es-ude/eeg-hardware/0_hardware/EEG.kicad_sch

## KiCad design 0_hardware/EEG.kicad_sch (2026-02-24)

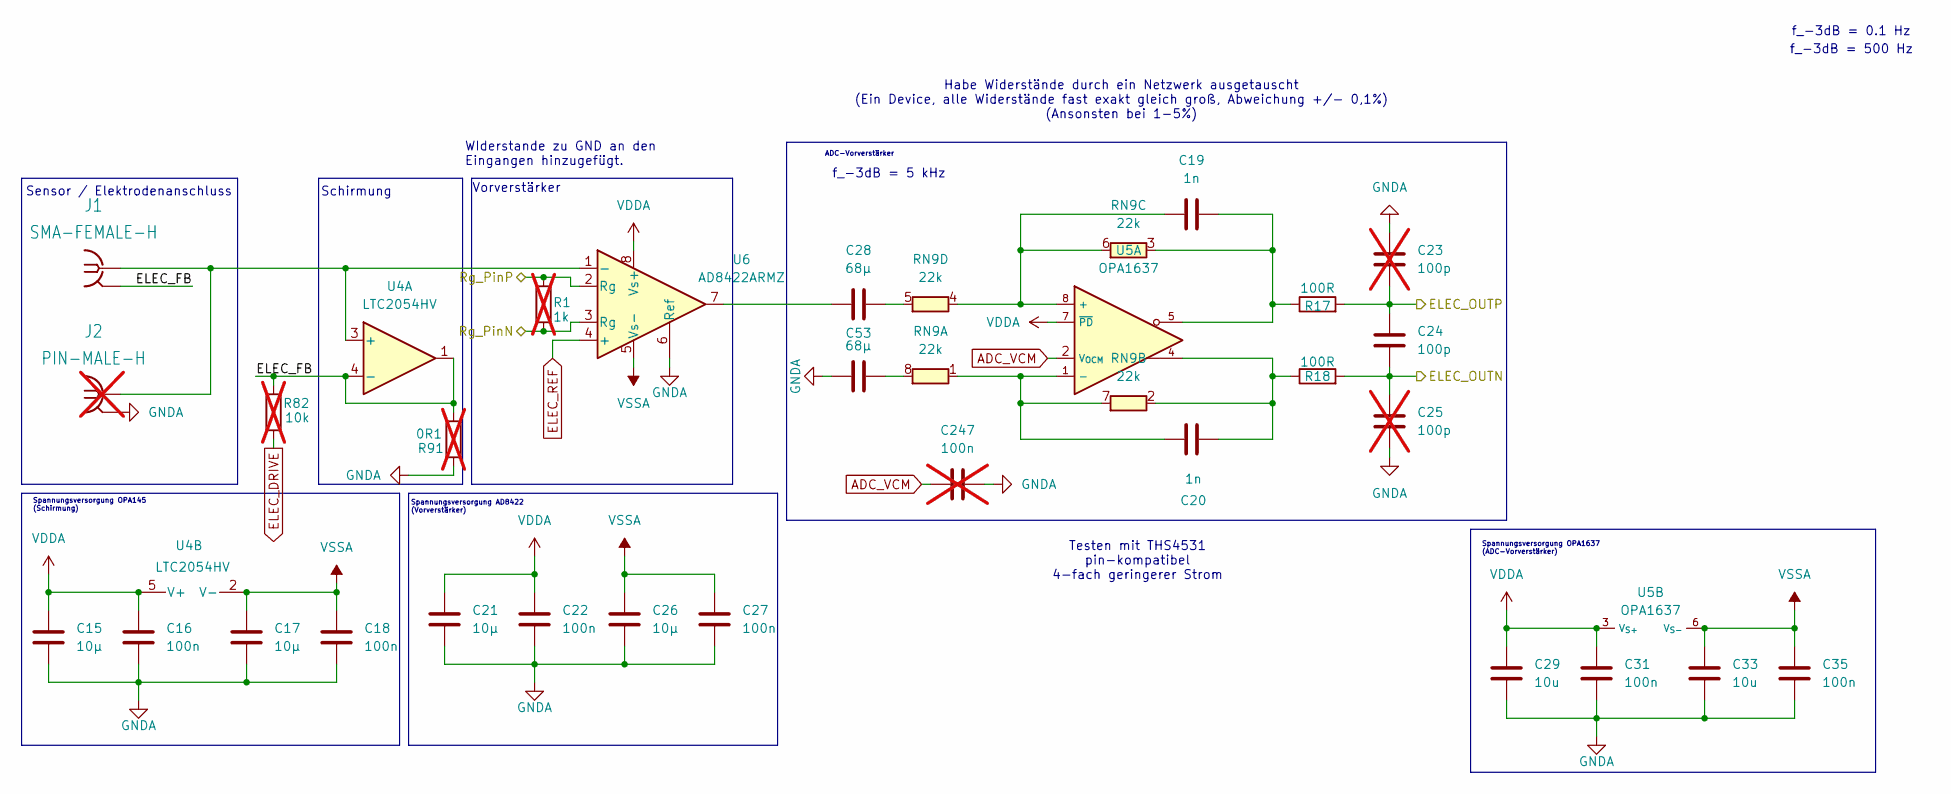
[picture p1: schematic EEG.kicad_sch]

Parts:
C15, C17, C21, C26: 10µ; C_0603_1608Metric
C16, C18, C22, C27, C31, C35: 100n; C_0603_1608Metric
C19, C20: 1n; C_0603_1608Metric
C23, C25: 100p; C_0603_1608Metric; not fitted
C24: 100p; C_0603_1608Metric
C28, C53: 68µ; C_0603_1608Metric
C29, C33: 10u; C_0603_1608Metric
C247: 100n; C_0603_1608Metric; not fitted
J1: SMA-FEMALE-H; SMA_Samtec_SMA-J-P-H-ST-EM1_EdgeMount
J2: PIN-MALE-H; PinHeader_1x02_P2.54mm_Vertical; not fitted
R1: 1k; R_0603_1608Metric; not fitted
R17, R18: 100R; R_0603_1608Metric
R82: 10k; R_0603_1608Metric; not fitted
R91: 0R1; R_0603_1608Metric; not fitted
RN9: 22k; RES_YC164_CAXE80P320X160X70
U4: LTC2054HV; SOT-23-5_HandSoldering
U5: OPA1637; VSSOP-8_3x3mm_P0.65mm
U6: AD8422ARMZ; MSOP-8_3x3mm_P0.65mm

Connections:
ADC_VCM: C247.1, U5.2 (V_{OCM})
ELEC_DRIVE: R82.1
ELEC_FB: J1.2 (GND), R82.2, R91.1, U4.1, U4.4 (-)
ELEC_OUTN: C24.2, C25.1, R18.2
ELEC_OUTP: C23.2, C24.1, R17.2
ELEC_REF: U6.4 (+)
GNDA: C15.2, C16.2, C17.2, C18.2, C21.2, C22.2, C23.1, C25.2, C26.2, C27.2, C29.2, C31.2, C33.2, C35.2, C53.2, C247.2, J2.2 (GND), R91.2, U6.6 (Ref)
unnamed: C19.1, RN9.4 (R4.1), RN9.6 (R3.2), U5.8 (+)
unnamed: C19.2, R17.1, RN9.3 (R3.1), U5.5
unnamed: C20.1, RN9.1 (R1.1), RN9.7 (R2.2), U5.1 (-)
unnamed: C20.2, R18.1, RN9.2 (R2.1), U5.4
unnamed: C28.1, RN9.5 (R4.2)
unnamed: C28.2, U6.7
unnamed: C53.1, RN9.8 (R1.2)
unnamed: J1.1 (SIG), J2.1 (SIG), U4.3 (+), U6.1 (-)
Rg_PinN: R1.1, U6.3 (Rg)
Rg_PinP: R1.2, U6.2 (Rg)
VDDA: C15.1, C16.1, C21.1, C22.1, C29.1, C31.1, U4.5 (V+), U5.3 (V_{S+}), U5.7 (~PD), U6.8 (Vs+)
VSSA: C17.1, C18.1, C26.1, C27.1, C33.1, C35.1, U4.2 (V-), U5.6 (V_{S-}), U6.5 (Vs-)

Notes on the sheet:
Spannungsversorgung AD8422 (Vorverstärker)
f_-3dB = 0.1 Hz
Testen mit THS4531 pin-kompatibel 4-fach geringerer Strom
Schirmung
Vorverstärker
Spannungsversorgung OPA1637 (ADC-Vorverstärker)
Spannungsversorgung OPA145 (Schirmung)
ADC-Vorverstärker
Sensor / Elektrodenanschluss
Habe Widerstände durch ein Netzwerk ausgetauscht (Ein Device, alle Widerstände fast exakt gleich groß, Abweichung +/- 0,1%) (Ansonsten bei 1-5%)
f_-3dB = 500 Hz
WIderstande zu GND an den Eingangen hinzugefügt.
f_-3dB = 5 kHz
