es-ude/eeg-hardware/0_hardware/VarWiderstand.kicad_sch

## KiCad design 0_hardware/VarWiderstand.kicad_sch (2026-02-24)

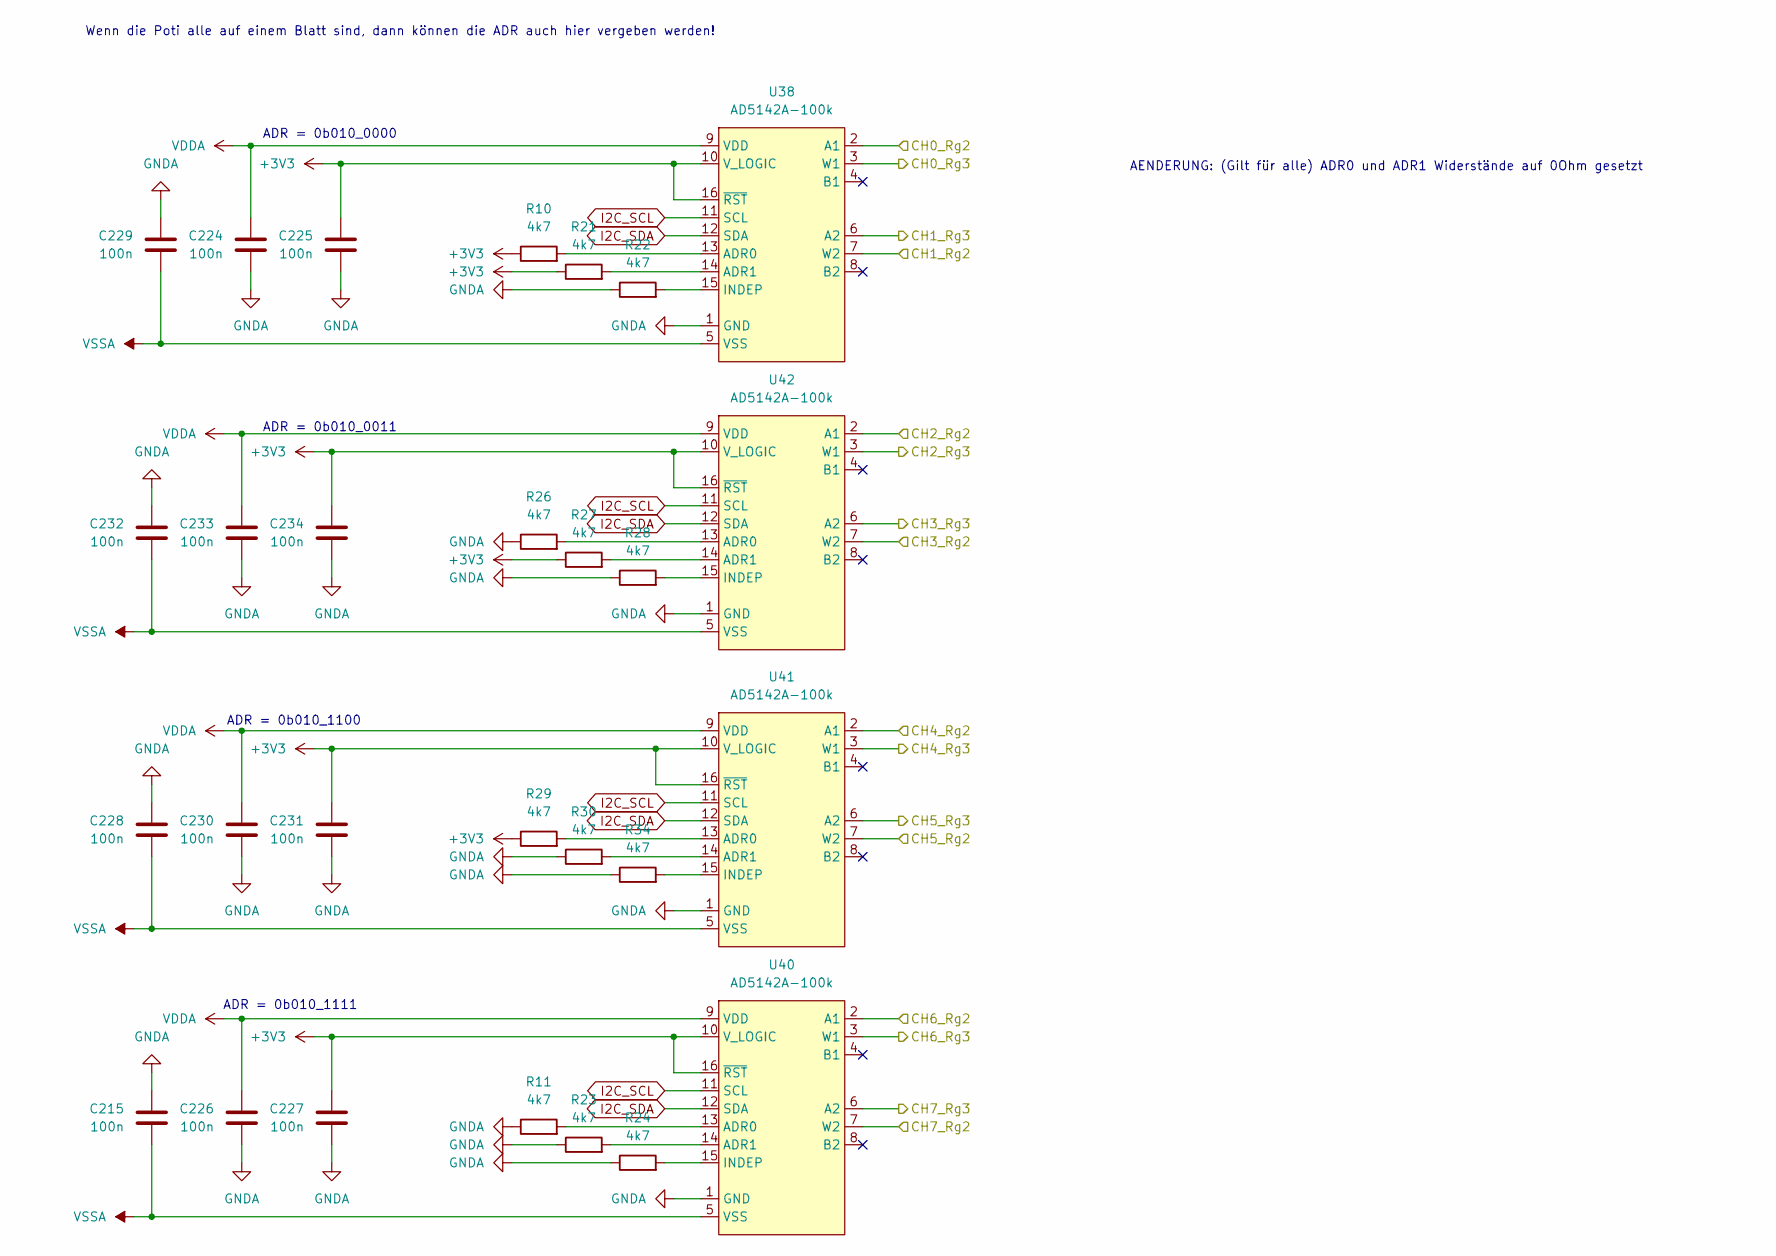
[picture p2: schematic VarWiderstand.kicad_sch]

Parts:
C215, C224, C225, C226, C227, C228, C229, C230, C231, C232, C233, C234: 100n; C_0603_1608Metric
R10, R11, R21, R22, R23, R24, R26, R27, R28, R29, R30, R34: 4k7; R_0603_1608Metric
U38, U40, U41, U42: AD5142A-100k; LFCSP-16-1EP_3x3mm_P0.5mm_EP1.5x1.5mm

Connections:
+3V3: C225.1, C227.1, C231.1, C234.1, R10.1, R21.1, R27.1, R29.1, U38.10 (V_LOGIC), U38.16 (~RST), U40.10 (V_LOGIC), U40.16 (~RST), U41.10 (V_LOGIC), U41.16 (~RST), U42.10 (V_LOGIC), U42.16 (~RST)
CH0_Rg2: U38.2 (A1)
CH0_Rg3: U38.3 (W1)
CH1_Rg2: U38.7 (W2)
CH1_Rg3: U38.6 (A2)
CH2_Rg2: U42.2 (A1)
CH2_Rg3: U42.3 (W1)
CH3_Rg2: U42.7 (W2)
CH3_Rg3: U42.6 (A2)
CH4_Rg2: U41.2 (A1)
CH4_Rg3: U41.3 (W1)
CH5_Rg2: U41.7 (W2)
CH5_Rg3: U41.6 (A2)
CH6_Rg2: U40.2 (A1)
CH6_Rg3: U40.3 (W1)
CH7_Rg2: U40.7 (W2)
CH7_Rg3: U40.6 (A2)
GNDA: C215.1, C224.2, C225.2, C226.2, C227.2, C228.1, C229.1, C230.2, C231.2, C232.1, C233.2, C234.2, R11.1, R22.1, R23.1, R24.1, R26.1, R28.1, R30.1, R34.1, U38.1 (GND), U40.1 (GND), U41.1 (GND), U42.1 (GND)
I2C_SCL: U38.11 (SCL), U40.11 (SCL), U41.11 (SCL), U42.11 (SCL)
I2C_SDA: U38.12 (SDA), U40.12 (SDA), U41.12 (SDA), U42.12 (SDA)
unnamed: R10.2, U38.13 (ADR0)
unnamed: R11.2, U40.13 (ADR0)
unnamed: R21.2, U38.14 (ADR1)
unnamed: R22.2, U38.15 (INDEP)
unnamed: R23.2, U40.14 (ADR1)
unnamed: R24.2, U40.15 (INDEP)
unnamed: R26.2, U42.13 (ADR0)
unnamed: R27.2, U42.14 (ADR1)
unnamed: R28.2, U42.15 (INDEP)
unnamed: R29.2, U41.13 (ADR0)
unnamed: R30.2, U41.14 (ADR1)
unnamed: R34.2, U41.15 (INDEP)
VDDA: C224.1, C226.1, C230.1, C233.1, U38.9 (VDD), U40.9 (VDD), U41.9 (VDD), U42.9 (VDD)
VSSA: C215.2, C228.2, C229.2, C232.2, U38.5 (VSS), U38.17 (EXP), U40.5 (VSS), U40.17 (EXP), U41.5 (VSS), U41.17 (EXP), U42.5 (VSS), U42.17 (EXP)

Notes on the sheet:
AENDERUNG: (Gilt für alle) ADR0 und ADR1 Widerstände auf 0Ohm gesetzt
ADR = 0b010_0000
Wenn die Poti alle auf einem Blatt sind, dann können die ADR auch hier vergeben werden!
ADR = 0b010_1111
ADR = 0b010_0011
ADR = 0b010_1100
