es-ude/eeg-hardware/0_hardware/adc.kicad_sch

## KiCad design 0_hardware/adc.kicad_sch (2026-02-24)

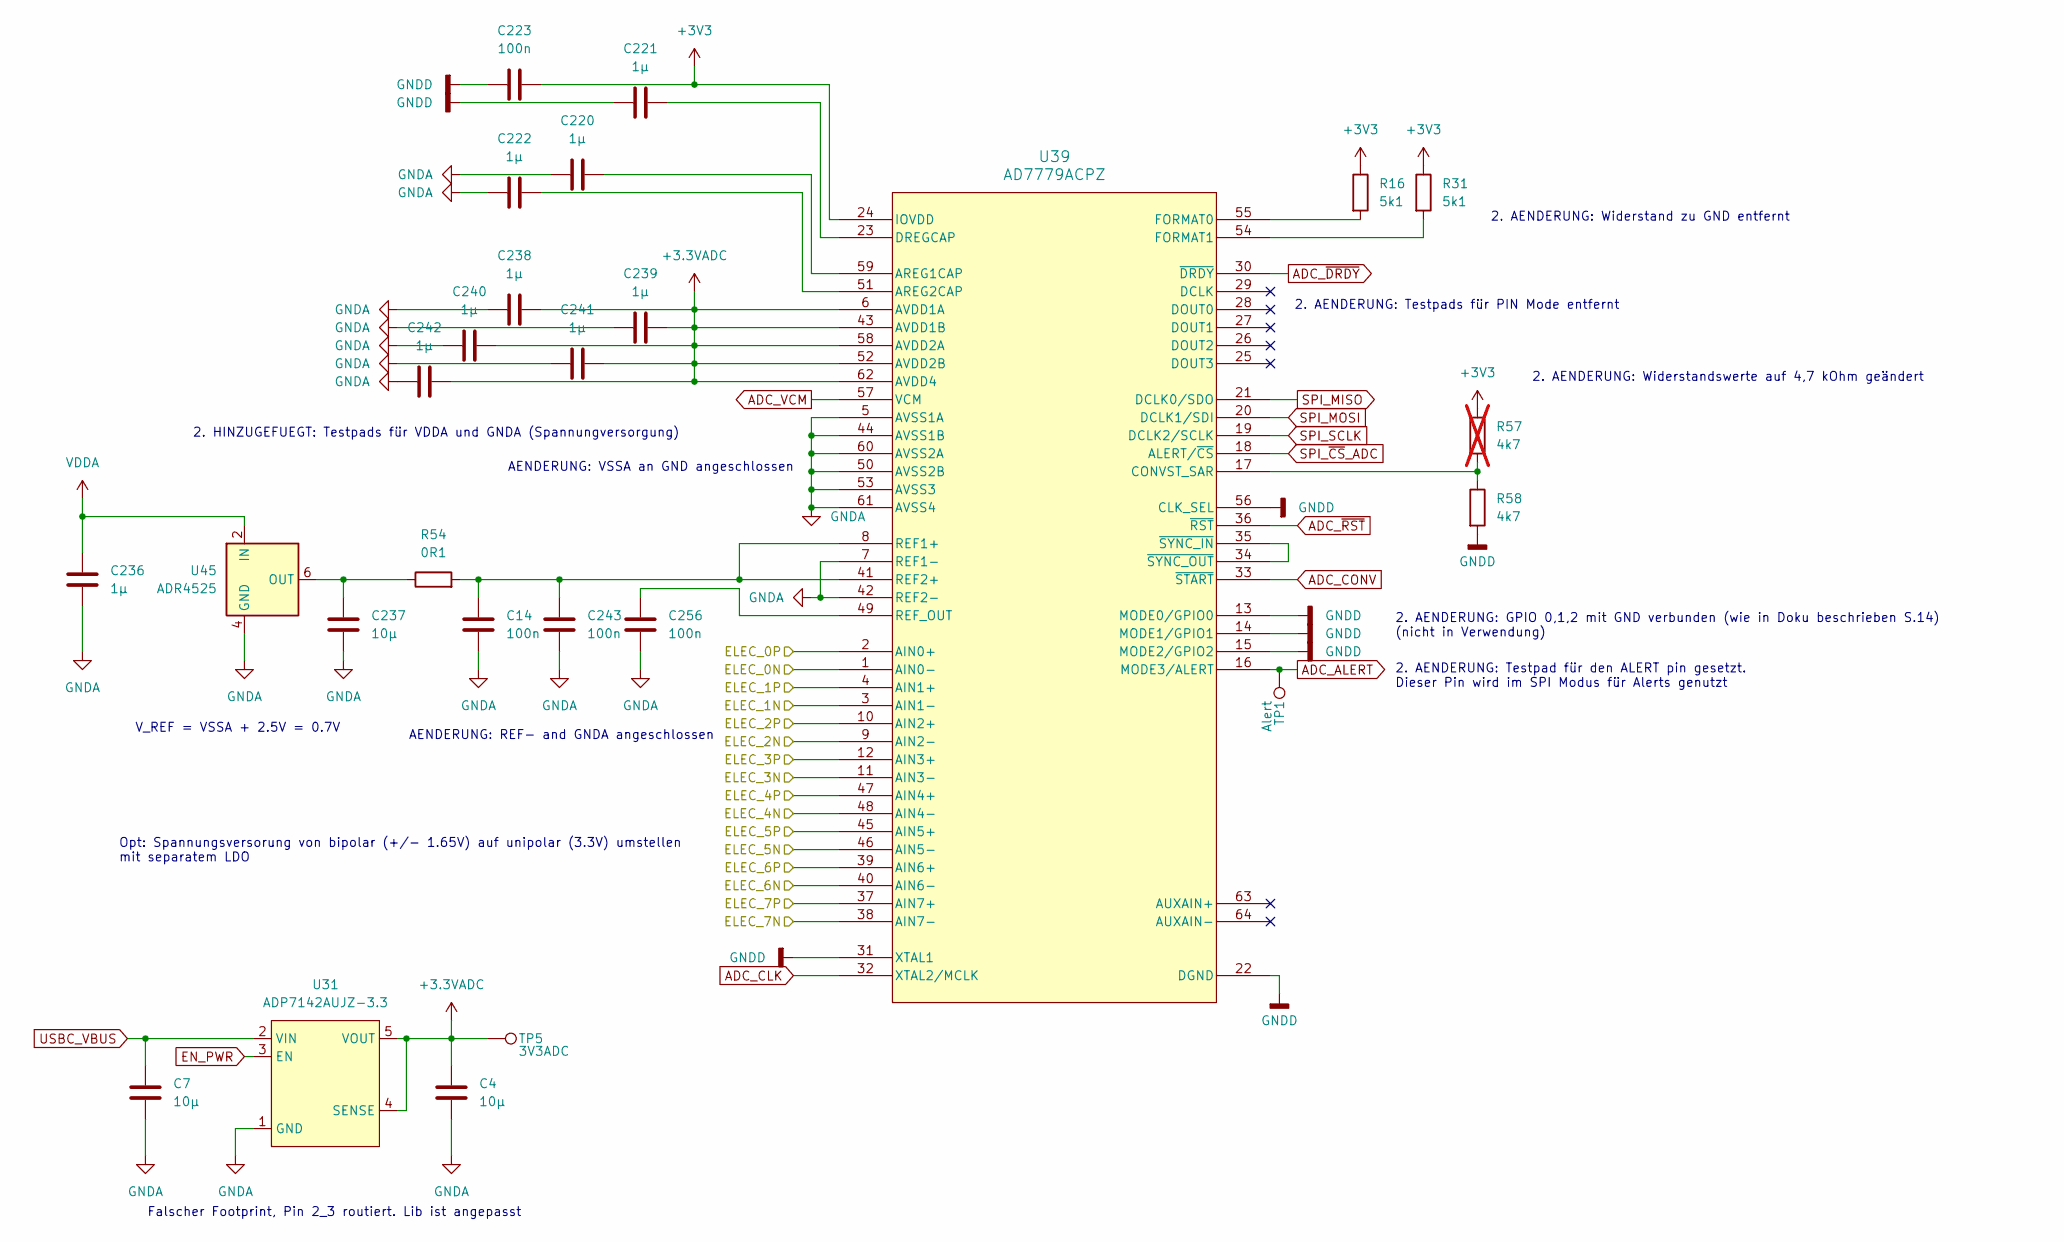
[picture p3: schematic adc.kicad_sch]

Parts:
C4, C7, C237: 10µ; C_0603_1608Metric
C14, C223, C243, C256: 100n; C_0603_1608Metric
C220, C221, C222, C236, C238, C239, C240, C241, C242: 1µ; C_0603_1608Metric
R16, R31: 5k1; R_0603_1608Metric
R54: 0R1; R_0603_1608Metric
R57: 4k7; R_0603_1608Metric; not fitted
R58: 4k7; R_0603_1608Metric
TP1: Alert; TestPoint_Pad_1.0x1.0mm
TP5: 3V3ADC; TestPoint_Pad_1.0x1.0mm
U31: ADP7142AUJZ-3.3; TSOT-23-5
U39: AD7779ACPZ; LFCSP-64-1EP_9x9mm_P0.5mm_EP5.21x5.21mm_ThermalVias
U45: ADR4525; SOIC-8_3.9x4.9mm_P1.27mm

Connections:
+3.3VADC: C4.1, C238.2, C239.1, C240.2, C241.1, C242.2, TP5.1, U31.4 (SENSE), U31.5 (VOUT), U39.6 (AVDD1A), U39.43 (AVDD1B), U39.52 (AVDD2B), U39.58 (AVDD2A), U39.62 (AVDD4)
+3V3: C223.2, R16.1, R31.1, R57.1, U39.24 (IOVDD)
ADC_ALERT: TP1.1, U39.16 (MODE3/ALERT)
ADC_CLK: U39.32 (XTAL2/MCLK)
ADC_CONV: U39.33 (~START)
ADC_VCM: U39.57 (VCM)
ADC_~DRDY: U39.30 (~DRDY)
ADC_~RST: U39.36 (~RST)
ELEC_0N: U39.1 (AIN0-)
ELEC_0P: U39.2 (AIN0+)
ELEC_1N: U39.3 (AIN1-)
ELEC_1P: U39.4 (AIN1+)
ELEC_2N: U39.9 (AIN2-)
ELEC_2P: U39.10 (AIN2+)
ELEC_3N: U39.11 (AIN3-)
ELEC_3P: U39.12 (AIN3+)
ELEC_4N: U39.48 (AIN4-)
ELEC_4P: U39.47 (AIN4+)
ELEC_5N: U39.46 (AIN5-)
ELEC_5P: U39.45 (AIN5+)
ELEC_6N: U39.40 (AIN6-)
ELEC_6P: U39.39 (AIN6+)
ELEC_7N: U39.38 (AIN7-)
ELEC_7P: U39.37 (AIN7+)
EN_PWR: U31.3 (EN)
GNDA: C4.2, C7.2, C14.1, C220.2, C222.2, C236.2, C237.2, C238.1, C239.2, C240.1, C241.2, C242.1, C243.1, C256.1, U31.1 (GND), U39.5 (AVSS1A), U39.7 (REF1-), U39.42 (REF2-), U39.44 (AVSS1B), U39.50 (AVSS2B), U39.53 (AVSS3), U39.60 (AVSS2A), U39.61 (AVSS4), U39.65 (EP(GND)), U45.4 (GND)
GNDD: C221.2, C223.1, R58.2, U39.13 (MODE0/GPIO0), U39.14 (MODE1/GPIO1), U39.15 (MODE2/GPIO2), U39.22 (DGND), U39.31 (XTAL1), U39.56 (CLK_SEL)
unnamed: C14.2, C243.2, R54.2, U39.8 (REF1+), U39.41 (REF2+)
unnamed: C220.1, U39.59 (AREG1CAP)
unnamed: C221.1, U39.23 (DREGCAP)
unnamed: C222.1, U39.51 (AREG2CAP)
unnamed: C237.1, R54.1, U45.6 (OUT)
unnamed: C256.2, U39.49 (REF_OUT)
unnamed: R16.2, U39.55 (FORMAT0)
unnamed: R31.2, U39.54 (FORMAT1)
unnamed: R57.2, R58.1, U39.17 (CONVST_SAR)
unnamed: U39.34 (~SYNC_OUT), U39.35 (~SYNC_IN)
SPI_MISO: U39.21 (DCLK0/SDO)
SPI_MOSI: U39.20 (DCLK1/SDI)
SPI_SCLK: U39.19 (DCLK2/SCLK)
SPI_~CS_ADC: U39.18 (ALERT/~CS)
USBC_VBUS: C7.1, U31.2 (VIN)
VDDA: C236.1, U45.2 (IN)

Notes on the sheet:
2. HINZUGEFUEGT: Testpads für VDDA und GNDA (Spannungversorgung)
Falscher Footprint, Pin 2_3 routiert. Lib ist angepasst
Opt: Spannungsversorung von bipolar (+/- 1.65V) auf unipolar (3.3V) umstellen mit separatem LDO
2. AENDERUNG: GPIO 0,1,2 mit GND verbunden (wie in Doku beschrieben S.14) (nicht in Verwendung)
2. AENDERUNG: Widerstand zu GND entfernt
V_REF = VSSA + 2.5V = 0.7V
AENDERUNG: REF- and GNDA angeschlossen
2. AENDERUNG: Testpad für den ALERT pin gesetzt. Dieser Pin wird im SPI Modus für Alerts genutzt
2. AENDERUNG: Widerstandswerte auf 4,7 kOhm geändert
AENDERUNG: VSSA an GND angeschlossen
2. AENDERUNG: Testpads für PIN Mode entfernt
