es-ude/eeg-hardware/0_hardware/eeg_hardware_v2.kicad_sch

## KiCad design 0_hardware/eeg_hardware_v2.kicad_sch (2026-02-24)

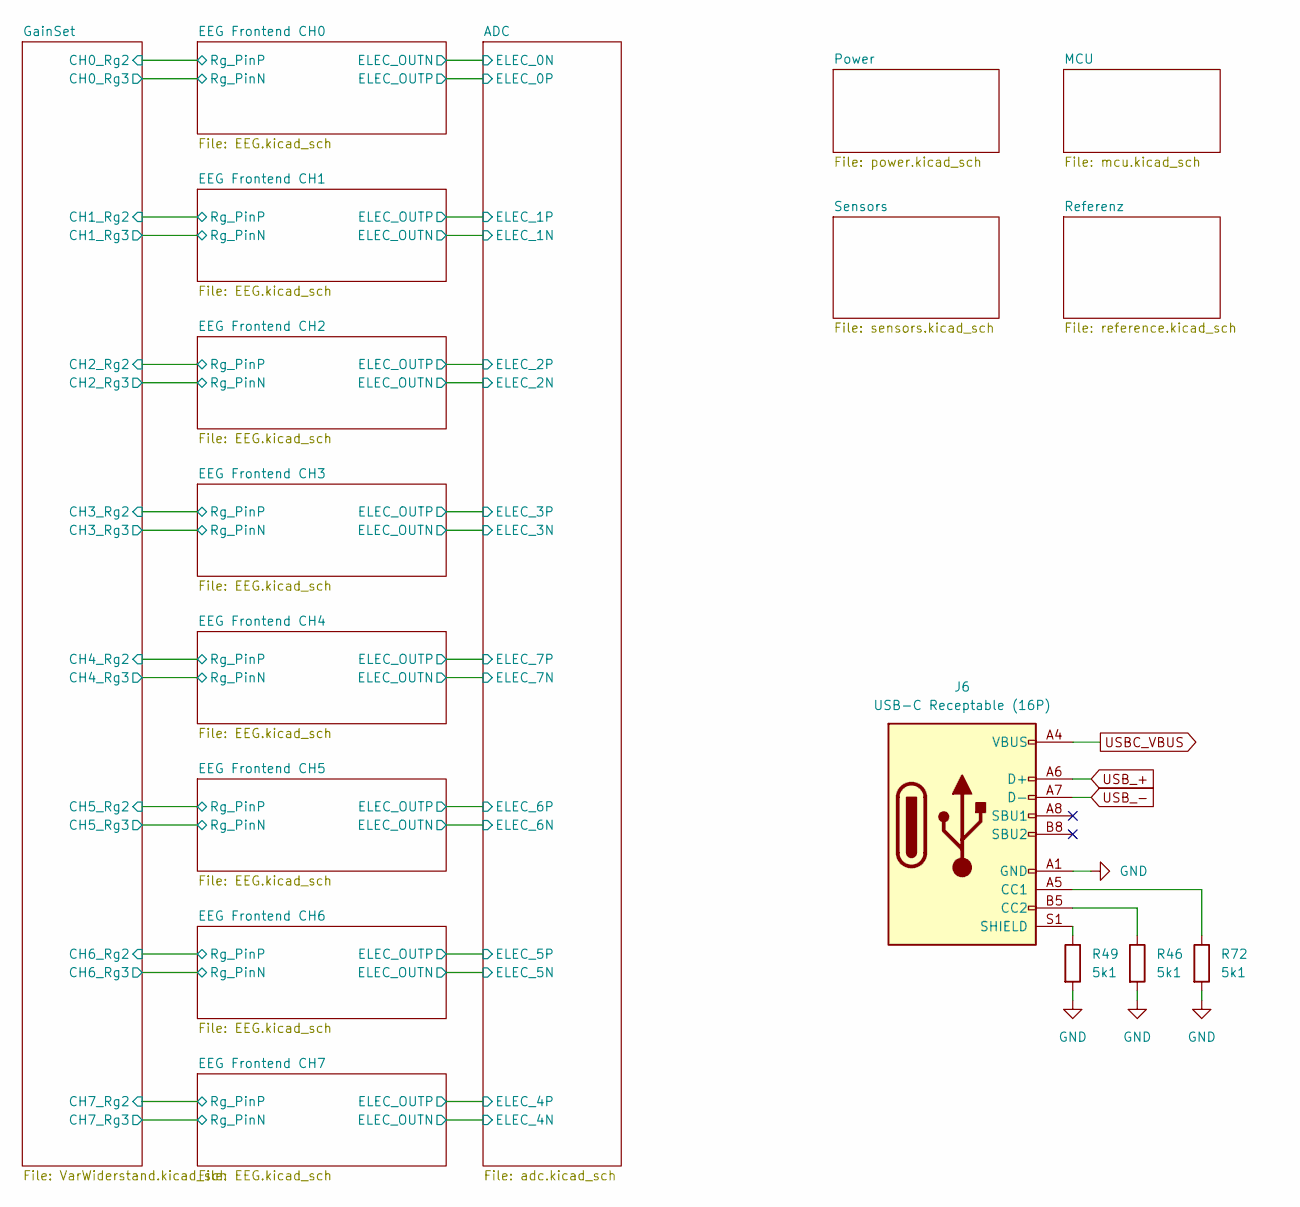
[picture p4: schematic eeg_hardware_v2.kicad_sch]

Parts:
J6: USB-C Receptable (16P); USB_C_Receptacle_16P
R46, R49, R72: 5k1; R_0402_1005Metric

Connections:
GND: J6.A1 (GND), J6.A12 (GND), J6.B1 (GND), J6.B12 (GND), R46.2, R49.2, R72.2
unnamed: J6.A5 (CC1), R72.1
unnamed: J6.B5 (CC2), R46.1
unnamed: J6.S1 (SHIELD), R49.1
USBC_VBUS: J6.A4 (VBUS), J6.A9 (VBUS), J6.B4 (VBUS), J6.B9 (VBUS)
USB_+: J6.A6 (D+), J6.B6 (D+)
USB_-: J6.A7 (D-), J6.B7 (D-)
