es-ude/eeg-hardware/0_hardware/mcu.kicad_sch

## KiCad design 0_hardware/mcu.kicad_sch (2026-02-24)

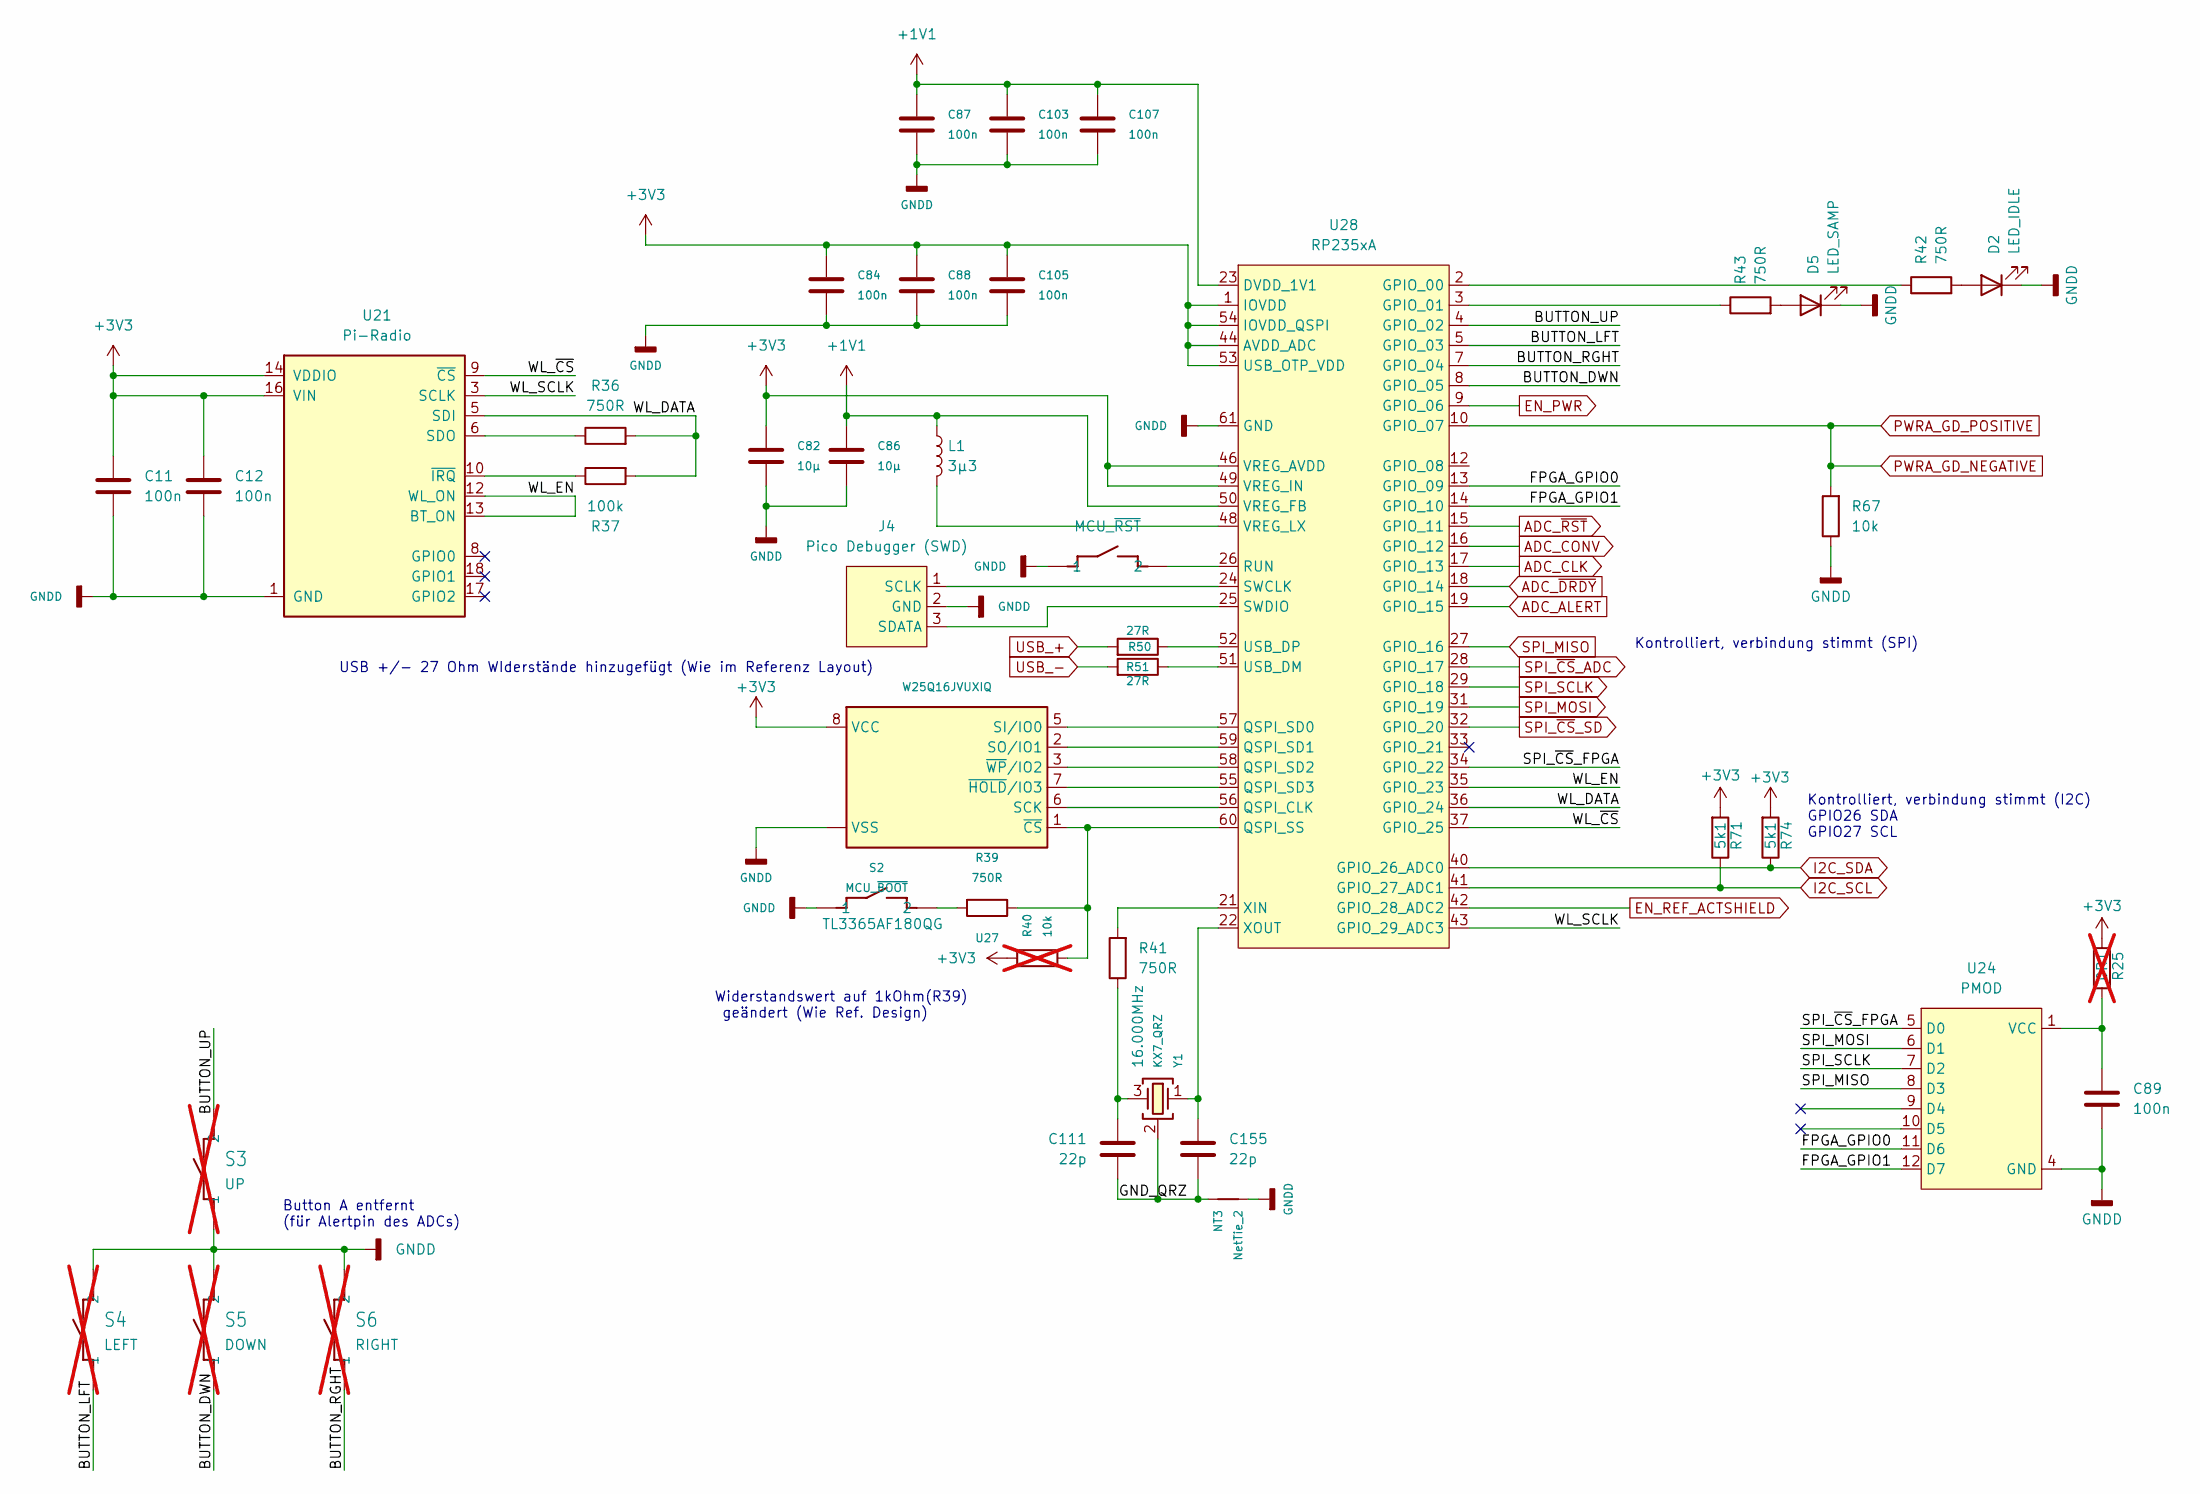
[picture p5: schematic mcu.kicad_sch]

Parts:
C11, C12, C84, C87, C88, C89, C103, C105, C107: 100n; C_0603_1608Metric
C82, C86: 10µ; C_0603_1608Metric
C111, C155: 22p; C_0603_1608Metric
D2: LED_IDLE; LED_0603_1608Metric
D5: LED_SAMP; LED_0603_1608Metric
J4: Pico Debugger (SWD); PinHeader_1x03_P2.54mm_Vertical
L1: 3µ3; R_0805_2012Metric_Pad1.20x1.40mm_HandSolder
NT3: NetTie_2; NetTie-2_SMD_Pad0.5mm
R25: 0R1; R_0603_1608Metric; not fitted
R36, R39, R41, R42, R43: 750R; R_0603_1608Metric
R37: 100k; R_0603_1608Metric
R40: 10k; R_0603_1608Metric; not fitted
R50, R51: 27R; R_0402_1005Metric
R67: 10k; R_0603_1608Metric
R71, R74: 5k1; R_0603_1608Metric
S2: MCU_~{BOOT}; TACTILE-SWITCH
S3: UP; TACTILE-SWITCH; not fitted
S4: LEFT; TACTILE-SWITCH; not fitted
S5: DOWN; TACTILE-SWITCH; not fitted
S6: RIGHT; TACTILE-SWITCH; not fitted
S8: MCU_~{RST}; TACTILE-SWITCH
U21: Pi-Radio; RPi-Radio-Module
U24: PMOD; PinHeader_2x06_P2.54mm_Vertical
U27: W25Q16JVUXIQ; USON-8-1EP_3x2mm_P0.5mm_EP0.2x1.6mm
U28: RP235xA; QFN-60_EP_7x7_Pitch0.4mm
Y1: KX7_QRZ; KX-7; MPN ABM8G-25.000MHZ-18-D2Y-T3

Connections:
+1V1: C86.2, C87.2, C103.2, C107.2, L1.1, U28.6 (DVDD_1V1), U28.23 (DVDD_1V1), U28.39 (DVDD_1V1), U28.50 (VREG_FB)
+3V3: C11.1, C12.1, C82.2, C84.2, C88.2, C105.2, R25.2, R40.2, R71.2, R74.2, U21.14 (VDDIO), U21.16 (VIN), U27.8 (VCC), U28.1 (IOVDD), U28.11 (IOVDD), U28.20 (IOVDD), U28.30 (IOVDD), U28.38 (IOVDD), U28.44 (AVDD_ADC), U28.45 (IOVDD), U28.46 (VREG_AVDD), U28.49 (VREG_IN), U28.53 (USB_OTP_VDD), U28.54 (IOVDD_QSPI)
ADC_ALERT: U28.19 (GPIO_15)
ADC_CLK: U28.17 (GPIO_13)
ADC_CONV: U28.16 (GPIO_12)
ADC_~DRDY: U28.18 (GPIO_14)
ADC_~RST: U28.15 (GPIO_11)
BUTTON_DWN: S5.1, S5.2 (1), U28.8 (GPIO_05)
BUTTON_LFT: S4.1, S4.2 (1), U28.5 (GPIO_03)
BUTTON_RGHT: S6.1, S6.2 (1), U28.7 (GPIO_04)
BUTTON_UP: S3.3 (2), S3.4 (2), U28.4 (GPIO_02)
EN_PWR: U28.9 (GPIO_06)
EN_REF_ACTSHIELD: U28.42 (GPIO_28_ADC2)
FPGA_GPIO0: U24.11 (D6), U28.13 (GPIO_09)
FPGA_GPIO1: U24.12 (D7), U28.14 (GPIO_10)
GNDD: C11.2, C12.2, C82.1, C84.1, C86.1, C87.1, C88.1, C89.2, C103.1, C105.1, C107.1, D2.1 (K), D5.1 (K), J4.2 (GND), NT3.1, R67.1, S2.1, S2.2 (1), S3.1, S3.2 (1), S4.3 (2), S4.4 (2), S5.3 (2), S5.4 (2), S6.3 (2), S6.4 (2), S8.1, S8.2 (1), U21.1 (GND), U21.4 (GND), U21.7 (GND), U21.11 (GND), U21.15 (GND), U21.21 (GND), U24.3 (GND), U24.4 (GND), U27.4 (VSS), U27.9 (VSS), U28.47 (GND), U28.61 (GND)
GND_QRZ: C111.2, C155.2, NT3.2, Y1.2 (SH), Y1.4 (SH)
I2C_SCL: R71.1, U28.41 (GPIO_27_ADC1)
I2C_SDA: R74.1, U28.40 (GPIO_26_ADC0)
unnamed: C89.1, R25.1, U24.1 (VCC), U24.2 (VCC)
unnamed: C111.1, R41.1, Y1.3
unnamed: C155.1, U28.22 (XOUT), Y1.1
unnamed: D2.2 (A), R42.2
unnamed: D5.2 (A), R43.2
unnamed: J4.1 (SCLK), U28.24 (SWCLK)
unnamed: J4.3 (SDATA), U28.25 (SWDIO)
unnamed: L1.2, U28.48 (VREG_LX)
unnamed: R36.1, U21.6 (SDO)
unnamed: R37.1, U21.10 (~IRQ)
unnamed: R39.1, R40.1, U27.1 (~CS), U28.60 (QSPI_SS)
unnamed: R39.2, S2.3 (2), S2.4 (2)
unnamed: R41.2, U28.21 (XIN)
unnamed: R42.1, U28.2 (GPIO_00)
unnamed: R43.1, U28.3 (GPIO_01)
unnamed: R50.1, U28.52 (USB_DP)
unnamed: R51.1, U28.51 (USB_DM)
unnamed: S8.3 (2), S8.4 (2), U28.26 (RUN)
unnamed: U27.2 (SO/IO1), U28.59 (QSPI_SD1)
unnamed: U27.3 (~WP/IO2), U28.58 (QSPI_SD2)
unnamed: U27.5 (SI/IO0), U28.57 (QSPI_SD0)
unnamed: U27.6 (SCK), U28.56 (QSPI_CLK)
unnamed: U27.7 (~HOLD/IO3), U28.55 (QSPI_SD3)
PWRA_GD_NEGATIVE: R67.2, U28.10 (GPIO_07)
SPI_MISO: U24.8 (D3), U28.27 (GPIO_16)
SPI_MOSI: U24.6 (D1), U28.31 (GPIO_19)
SPI_SCLK: U24.7 (D2), U28.29 (GPIO_18)
SPI_~CS_ADC: U28.28 (GPIO_17)
SPI_~CS_FPGA: U24.5 (D0), U28.34 (GPIO_22)
SPI_~CS_SD: U28.32 (GPIO_20)
USB_+: R50.2
USB_-: R51.2
WL_DATA: R36.2, R37.2, U21.5 (SDI), U28.36 (GPIO_24)
WL_EN: U21.12 (WL_ON), U21.13 (BT_ON), U28.35 (GPIO_23)
WL_SCLK: U21.3 (SCLK), U28.43 (GPIO_29_ADC3)
WL_~CS: U21.9 (~CS), U28.37 (GPIO_25)

Notes on the sheet:
Kontrolliert, verbindung stimmt (I2C) GPIO26 SDA GPIO27 SCL
Widerstandswert auf 1kOhm(R39) geändert (Wie Ref. Design)
USB +/- 27 Ohm WIderstände hinzugefügt (Wie im Referenz Layout)
Kontrolliert, verbindung stimmt (SPI)
Button A entfernt (für Alertpin des ADCs)
