es-ude/eeg-hardware/0_hardware/power.kicad_sch

## KiCad design 0_hardware/power.kicad_sch (2026-02-24)

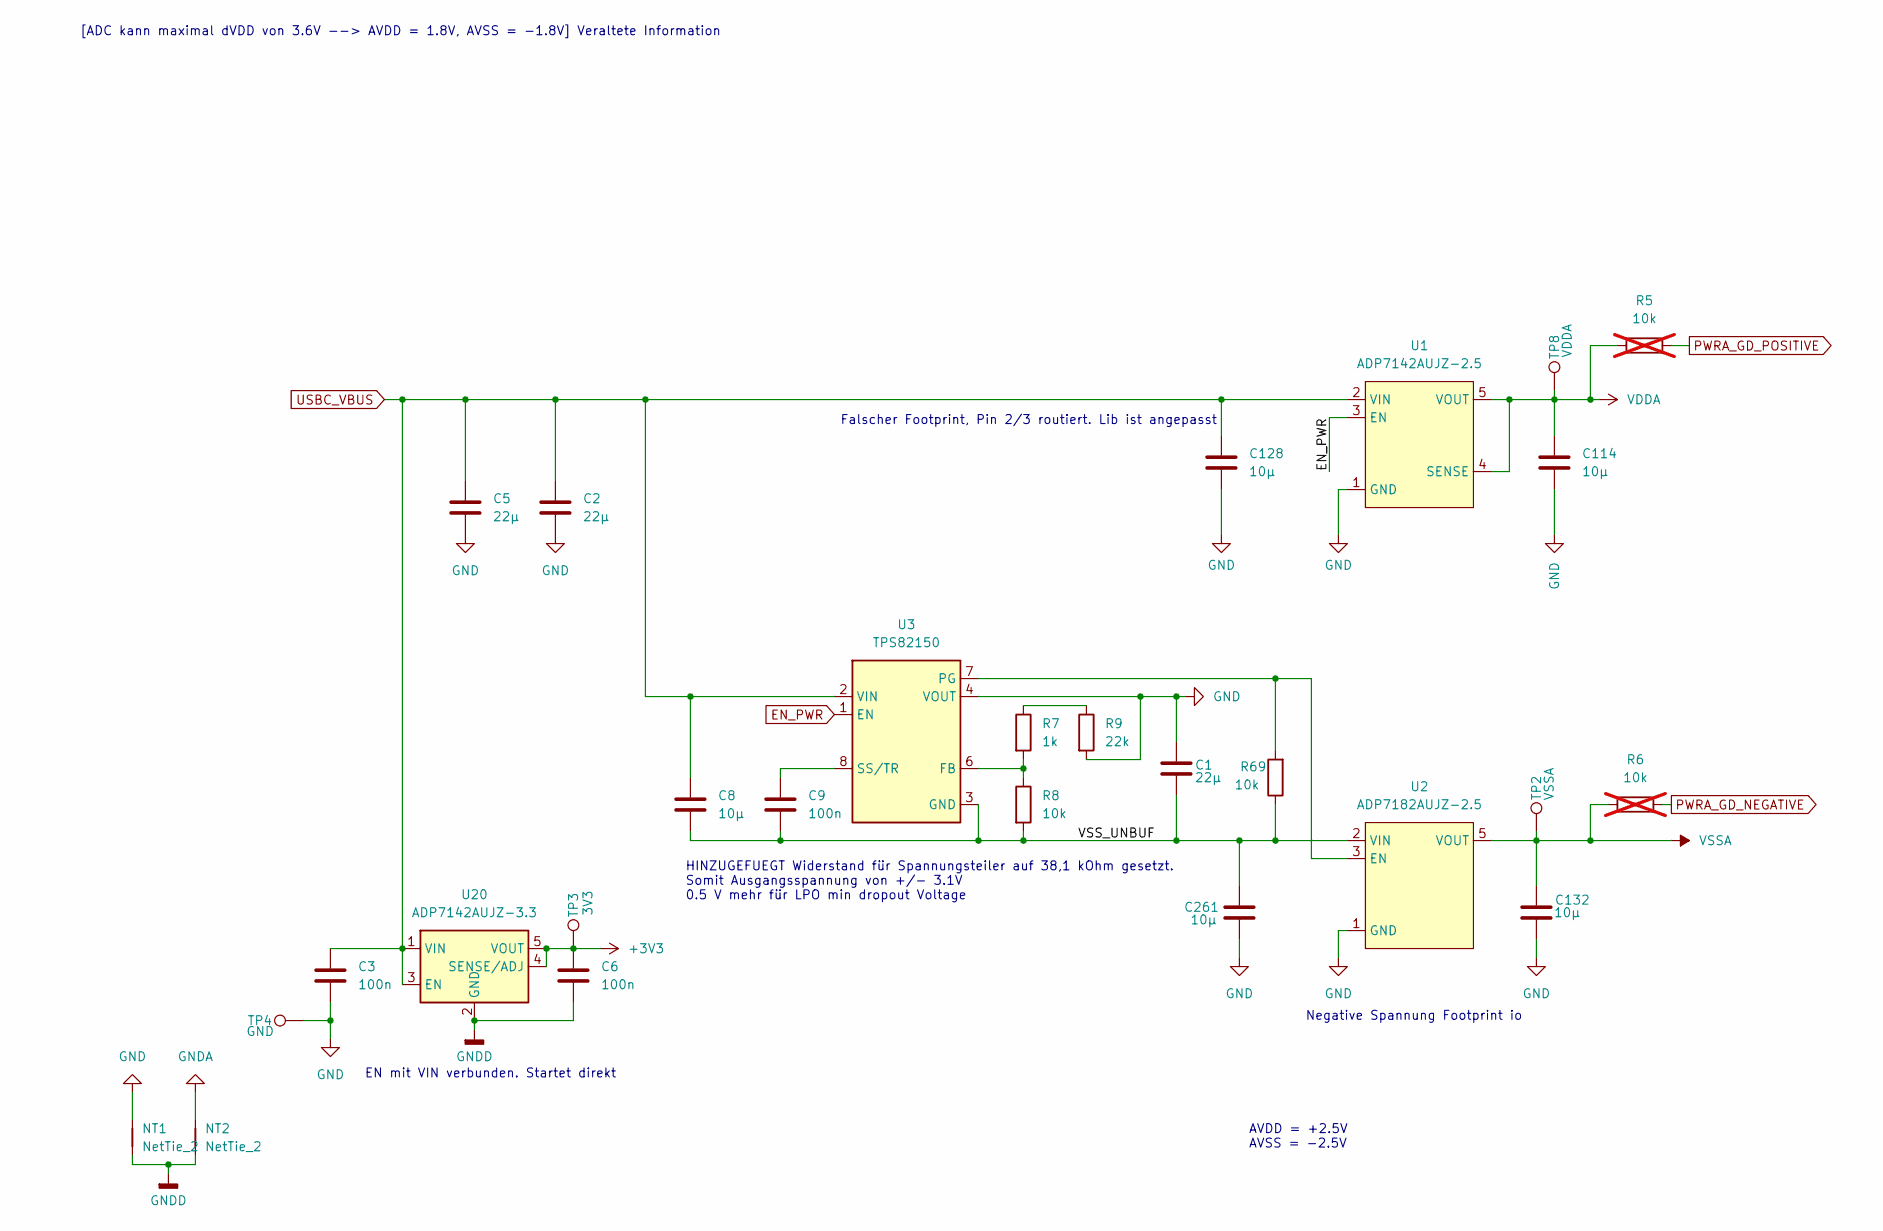
[picture p6: schematic power.kicad_sch]

Parts:
C1, C2, C5: 22µ; C_0603_1608Metric
C3, C6, C9: 100n; C_0603_1608Metric
C8, C114, C128, C132, C261: 10µ; C_0603_1608Metric
NT1, NT2: NetTie_2; NetTie-2_SMD_Pad2.0mm
R5, R6: 10k; R_0603_1608Metric; not fitted
R7: 1k; R_0603_1608Metric
R8, R69: 10k; R_0603_1608Metric
R9: 22k; R_0603_1608Metric
TP2: VSSA; TestPoint_Pad_1.0x1.0mm
TP3: 3V3; TestPoint_Pad_1.0x1.0mm
TP4: GND; TestPoint_Pad_1.0x1.0mm
TP8: VDDA; TestPoint_Pad_1.0x1.0mm
U1: ADP7142AUJZ-2.5; TSOT-23-5
U2: ADP7182AUJZ-2.5; TSOT-23-5
U3: TPS82150; Texas_SIL0008D_MicroSiP-8-1EP_2.8x3mm_P0.65mm_EP1.1x1.9mm
U20: ADP7142AUJZ-3.3; TSOT-23-5

Connections:
+3V3: C6.1, TP3.1, U20.4 (SENSE/ADJ), U20.5 (VOUT)
EN_PWR: U1.3 (EN), U3.1 (EN)
GND: C1.1, C2.2, C3.2, C5.2, C114.2, C128.2, C132.2, C261.2, NT1.2, R9.2, TP4.1, U1.1 (GND), U2.1 (GND), U3.4 (VOUT), U3.5 (VOUT)
GNDA: NT2.2
GNDD: C6.2, NT1.1, NT2.1, U20.2 (GND)
unnamed: C9.1, U3.8 (SS/TR)
unnamed: R7.1, R9.1
unnamed: R7.2, R8.1, U3.6 (FB)
unnamed: R69.2, U2.3 (EN), U3.7 (PG)
PWRA_GD_NEGATIVE: R6.2
PWRA_GD_POSITIVE: R5.2
USBC_VBUS: C2.1, C3.1, C5.1, C8.1, C128.1, U1.2 (VIN), U3.2 (VIN), U20.1 (VIN), U20.3 (EN)
VDDA: C114.1, R5.1, TP8.1, U1.4 (SENSE), U1.5 (VOUT)
VSSA: C132.1, R6.1, TP2.1, U2.5 (VOUT)
VSS_UNBUF: C1.2, C8.2, C9.2, C261.1, R8.2, R69.1, U2.2 (VIN), U3.3 (GND), U3.9 (GND)

Notes on the sheet:
Falscher Footprint, Pin 2/3 routiert. Lib ist angepasst
HINZUGEFUEGT Widerstand für Spannungsteiler auf 38,1 kOhm gesetzt. Somit Ausgangsspannung von +/- 3.1V 0.5 V mehr für LPO min dropout Voltage
Negative Spannung Footprint io
AVDD = +2.5V AVSS = -2.5V
[ADC kann maximal dVDD von 3.6V --> AVDD = 1.8V, AVSS = -1.8V] Veraltete Information
EN mit VIN verbunden. Startet direkt
