es-ude/eeg-hardware/0_hardware/reference.kicad_sch

## KiCad design 0_hardware/reference.kicad_sch (2026-02-24)

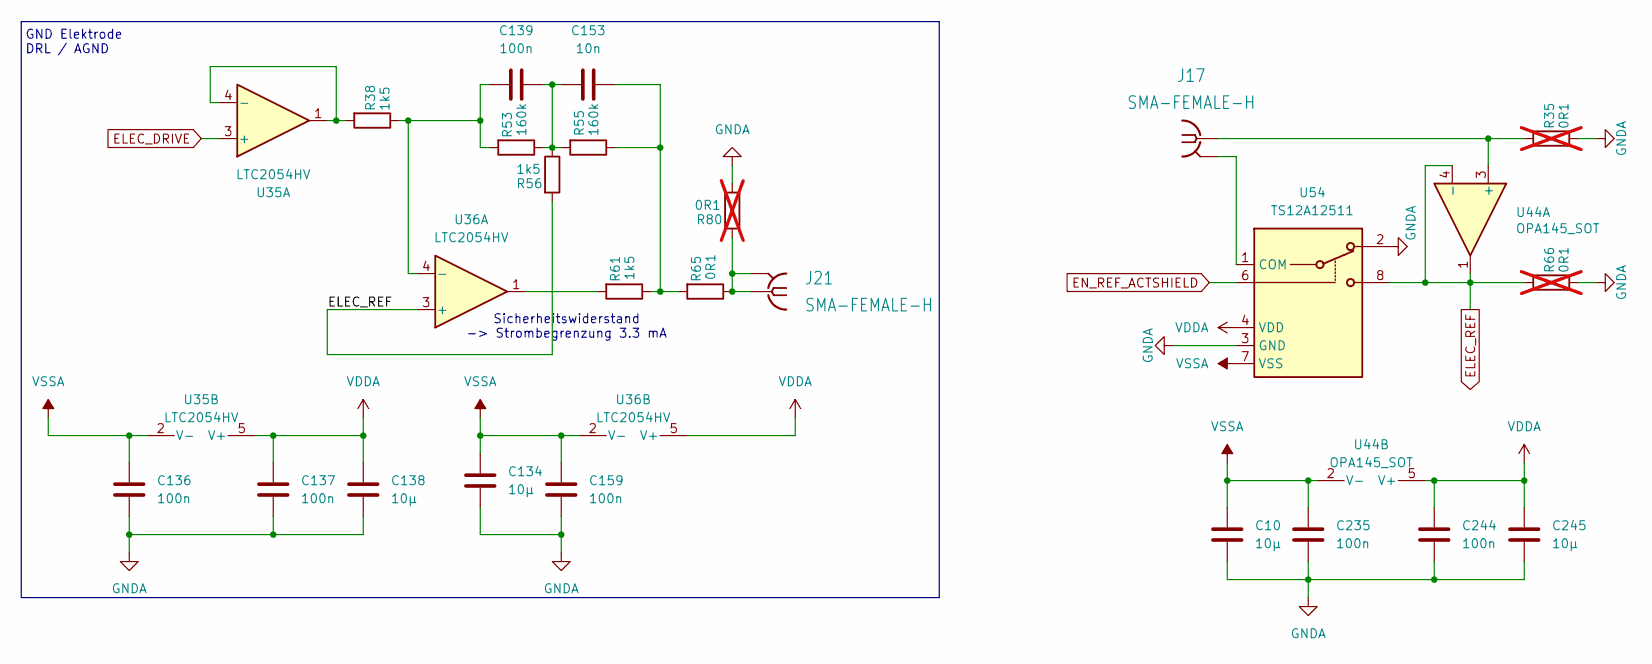
[picture p7: schematic reference.kicad_sch]

Parts:
C10, C134, C138, C245: 10µ; C_0603_1608Metric
C136, C137, C139, C159, C235, C244: 100n; C_0603_1608Metric
C153: 10n; C_0603_1608Metric
J17, J21: SMA-FEMALE-H; SMA_Samtec_SMA-J-P-H-ST-EM1_EdgeMount
R35, R66, R80: 0R1; R_0603_1608Metric; not fitted
R38, R56, R61: 1k5; R_0603_1608Metric
R53, R55: 160k; R_0603_1608Metric
R65: 0R1; R_0603_1608Metric
U35, U36: LTC2054HV; SOT-23-5_HandSoldering
U44: OPA145_SOT; SOT-23-5_HandSoldering
U54: TS12A12511; SOT-23-8

Connections:
ELEC_DRIVE: U35.3 (+)
ELEC_REF: R56.2, R66.2, U36.3 (+), U44.1, U44.4 (-), U54.8
EN_REF_ACTSHIELD: U54.6
GNDA: C10.2, C134.2, C136.2, C137.2, C138.2, C159.2, C235.2, C244.2, C245.2, R35.1, R66.1, R80.1, U54.2, U54.3 (GND)
unnamed: C139.1, R38.1, R53.2, U36.4 (-)
unnamed: C139.2, C153.1, R53.1, R55.2, R56.1
unnamed: C153.2, R55.1, R61.1, R65.2
unnamed: J17.1 (SIG), R35.2, U44.3 (+)
unnamed: J17.2 (GND), U54.1 (COM)
unnamed: J21.1 (SIG), J21.2 (GND), R65.1, R80.2
unnamed: R38.2, U35.1, U35.4 (-)
unnamed: R61.2, U36.1
VDDA: C137.1, C138.1, C244.1, C245.1, U35.5 (V+), U36.5 (V+), U44.5 (V+), U54.4 (VDD)
VSSA: C10.1, C134.1, C136.1, C159.1, C235.1, U35.2 (V-), U36.2 (V-), U44.2 (V-), U54.7 (VSS)

Notes on the sheet:
Sicherheitswiderstand -> Strombegrenzung 3.3 mA
GND Elektrode DRL / AGND
