es-ude/eeg-hardware/0_hardware/sensors.kicad_sch

## KiCad design 0_hardware/sensors.kicad_sch (2026-02-24)

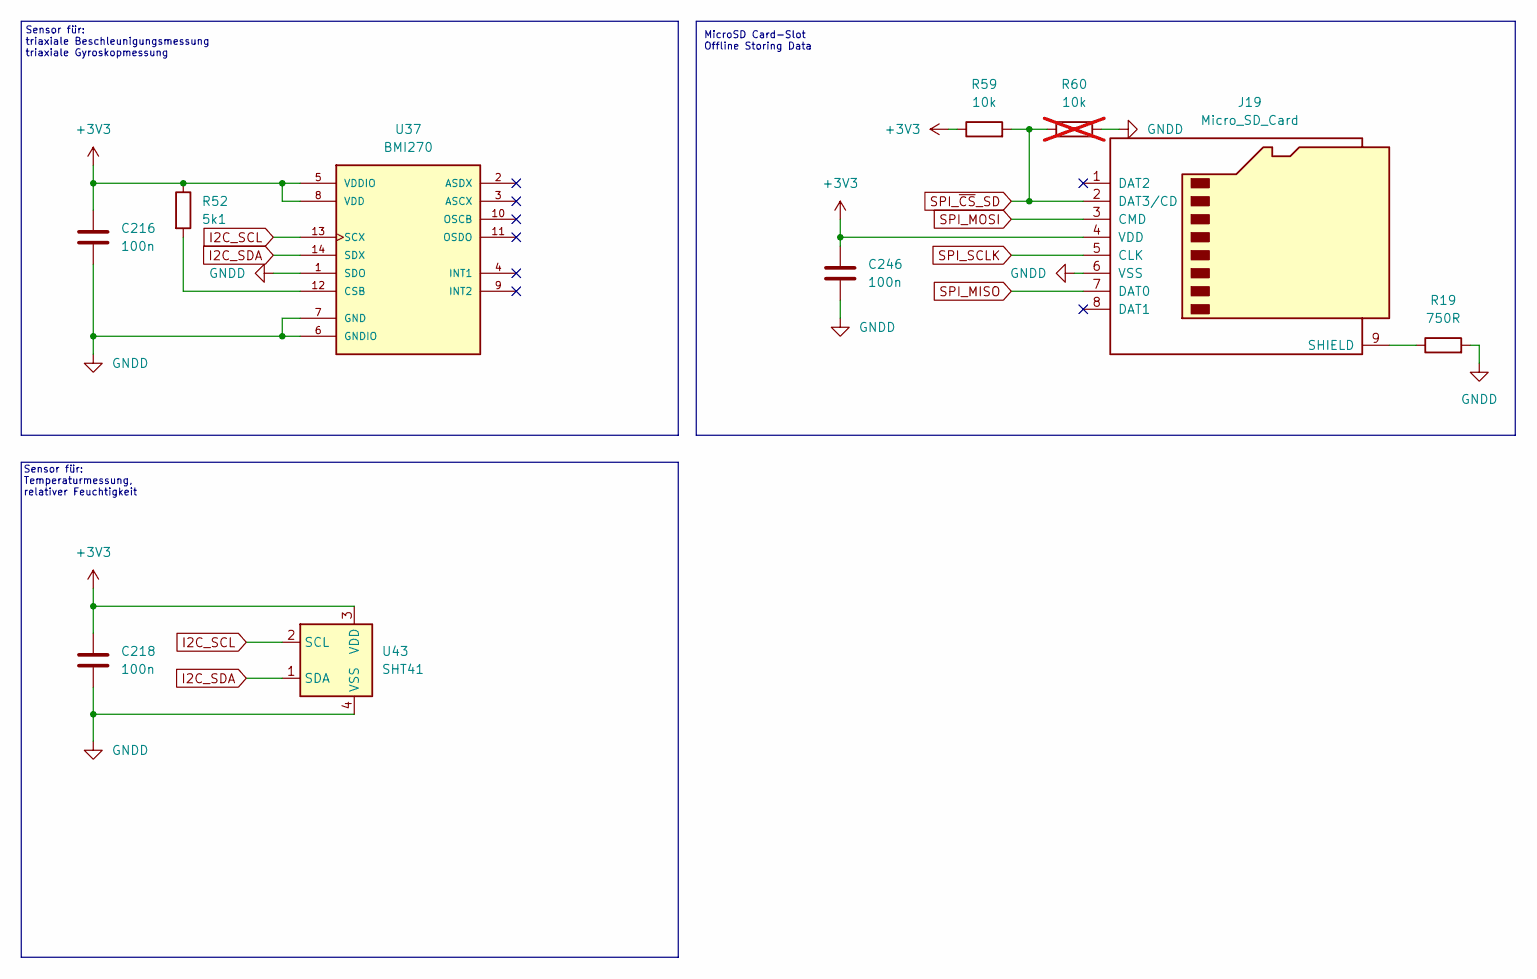
[picture p8: schematic sensors.kicad_sch]

Parts:
C216, C218, C246: 100n; C_0603_1608Metric
J19: Micro_SD_Card; microSD_HC_Wuerth_693072010801
R19: 750R; R_0603_1608Metric
R52: 5k1; R_0402_1005Metric
R59: 10k; R_0603_1608Metric
R60: 10k; R_0603_1608Metric; not fitted
U37: BMI270; XDCR_BMI270
U43: SHT41; Sensirion_DFN-4_1.5x1.5mm_P0.8mm_SHT4x_NoCentralPad

Connections:
+3V3: C216.1, C218.1, C246.1, J19.4 (VDD), R52.1, R59.1, U37.5 (VDDIO), U37.8 (VDD), U43.3 (VDD)
GNDD: C216.2, C218.2, C246.2, J19.6 (VSS), R19.2, R60.2, U37.1 (SDO), U37.6 (GNDIO), U37.7 (GND), U43.4 (VSS)
I2C_SCL: U37.13 (SCX), U43.2 (SCL)
I2C_SDA: U37.14 (SDX), U43.1 (SDA)
unnamed: J19.9 (SHIELD), R19.1
unnamed: R52.2, U37.12 (CSB)
SPI_MISO: J19.7 (DAT0)
SPI_MOSI: J19.3 (CMD)
SPI_SCLK: J19.5 (CLK)
SPI_~CS_SD: J19.2 (DAT3/CD), R59.2, R60.1

Notes on the sheet:
MicroSD Card-Slot Offline Storing Data
Sensor für: Temperaturmessung, relativer Feuchtigkeit
Sensor für: triaxiale Beschleunigungsmessung triaxiale Gyroskopmessung
