es-ude/eeg-hardware/1_firmware/callbacks/rpc_callbacks.h

#ifndef RPC_CALLBACKS_H_
#define RPC_CALLBACKS_H_


#include "pico/stdlib.h"


/*! \brief Function for processing the Remote Procedure Calls (RPC) with buffer content from an interface
* \param buffer    Char array with content to handle 
* \param length    Length of the char array
* \param ready     Flag indicating if the buffer is ready to be processed
* \return          True if a valid RPC command was found and processed, false otherwise  
*/
bool apply_rpc_callback(char* buffer, size_t length, bool ready);


#endif
