es-ude/eeg-hardware/1_firmware/src/init_system.h

#ifndef INIT_SYSTEM_H_
#define INIT_SYSTEM_H_


#include "pico/stdlib.h"
#include "stdbool.h"

/*! \brief Enum struct for defining suitable system states
*/
typedef enum{
    STATE_ERROR,
    STATE_RESET,
    STATE_INIT,
    STATE_IDLE,
    STATE_TEST,
    STATE_DAQ
} system_state_t;


/*! \brief Function for resetting the Pico MCU
* \param wait_until_done   Boolean for waiting routine until reset is done
*/
void reset_pico_mcu(bool wait_until_done);


/*! \brief  Function for initialisating the GPIO and modules of RP Pico (used in this system)
*   \param block_usb    Boolean for waiting routine until serial port is opened
*   \return             Boolean for initialisation of RPi Pico device completed
*/
bool init_gpio_pico(bool block_usb);


/*! \brief  Function for initialisating the PIO module for generating the ADC MCLK signal
    \return                           Boolean for done initialisation of PIO for ADC CLK generation
*/
bool init_pio_adc_clk();


/*! \brief  Function for initialisating the System Functionalities
    \return                           Boolean for done initialisation of system
*/
bool init_system(void);


/*! \brief Function for getting the runtime since last reboot
* \return                           Time structure with runtime in ms
*/
uint64_t get_runtime_ms(void);


/*! \brief Function for getting the status register of the system
*/
system_state_t get_system_state(void);


/*! \brief Function for getting the status register of the system
* \param state      New state to set
* \return           Boolean if new state is valid
*/
bool set_system_state(system_state_t state);


#endif
