es-ude/eeg-hardware/(commit log)

2026-02-23 Files for hardware version 2 added. Includes Kicad files, firmware, and the Python API.
    [EEG.kicad_sch, VarWiderstand.kicad_sch, adc.kicad_sch, eeg_hardware_v2.kicad_sch, fpga.kicad_sch, impedance.kicad_sch, mcu.kicad_sch, power.kicad_sch]
2026-02-24 Change the project structure; fix some unit tests
    [data_analysis.py, data_analysis_test.py, data_loading.py, data_loading_test.py, data_plotting.py, data_post_processing.py, data_post_processing_test.py]
2026-02-24 Changed the firmware for the AD7779 to the unified version from the Pico Runtime Library repository.
